lowderd/EmojiPad/README.md

# EmojiPad
ATmega328 Based USB HID Keyboard
