lowderd/EmojiPad/eagleUp/eagleUp_emojipad_v2_board_bottom.png

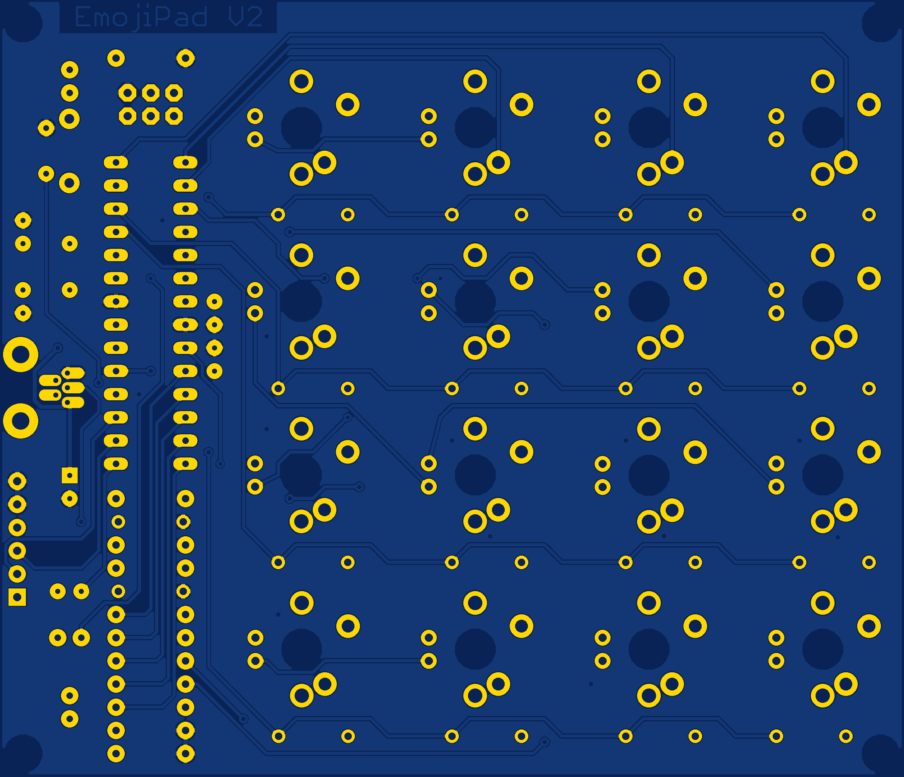
eagleUp/eagleUp_emojipad_v2_board_bottom.png
