lowderd/EmojiPad/eagleUp/eagleUp_emojipad_v2_board_top.png

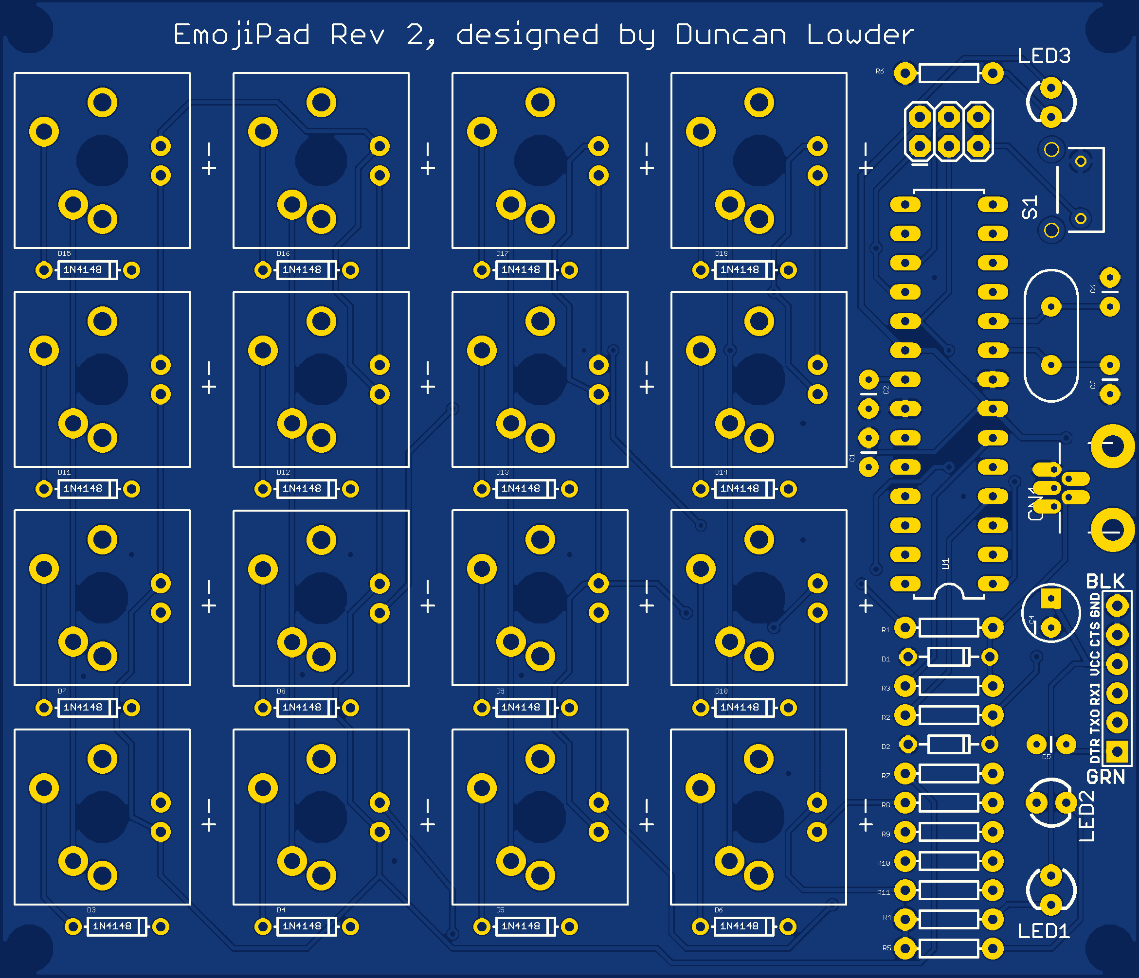
eagleUp/eagleUp_emojipad_v2_board_top.png
