lowderd/EmojiPad/EmojiPad_BOM_V1.xlsx

Sheet: BOM
Bill Of Materials -EmojiPad
Number of Devices: |  | 3
Item # | Designator | Name | Description | Manufacturer | Mfg. Part # | Distributor | Quantity | Price | Total | To Order
1 | U1 |  | IC MCU 8BIT 32KB FLASH 28DIP | Atmel | ATMEGA328-PU | Digikey | 3 | $3.41 | $10.23
2 | Y1 |  | CRYSTAL 16MHZ 20PF THRU | ECS Inc | ECS-160-20-4X | Digikey | 3 | $0.81 | $2.43
3 | C1, C3 |  | CAP CER 0.1UF 50V 20% RADIAL | Kemet | C315C104M5U5TA | Digikey | 6 | $0.30 | $1.80
4 | C2, C5 |  | CAP CER 22PF 200V 10% RADIAL | AVX Corporation | SR152A220KAR | Digikey | 6 | $0.31 | $1.86
5 | C3 |  | CAP ALUM 10UF 50V 20% RADIAL | Panasonic Electronic Components | EEU-FC1H100L | Digikey | 3 | $0.33 | $0.99
6 | R7, R8 |  | RES 68 OHM 1/4W 1% AXIAL | Stackpole Electronics Inc | RNMF14FTC68R0 | Digikey | 6 | $0.14 | $0.84
7 | D1, D2 |  | DIODE ZENER 3.6V 400MW ALF2 | NXP Semiconductors | BZX79-C3V6,133 | Digikey | 6 | $0.14 | $0.84
8 | S1 |  | SWITCH TACTILE SPST-NO 0.05A 24V | TE Connectivity | 1825027-5 | Digikey | 3 | $0.16 | $0.48
9 | R6 |  | RES 1.5K OHM 1/4W 5% CARBON FILM | Stackpole Electronics Inc | CF14JT1K50 | Digikey | 3 | $0.10 | $0.30
10 | CN1 |  | CONN USB RECEPTACLE 5POS RT ANG | Molex Inc | 548190519 | Digikey | 3 | $1.64 | $4.92
11 | D3-D18 |  | DIODE GEN PURP 100V 200MA DO35 | Fairchild Semiconductor | 1N4148TA | Digikey | 48 | $0.06 | $2.78
12 | SW1-SW16 |  | SWITCH PUSH SPST-NO 0.01A 12V | Cherry | MX1A-E1NW | Digikey | 48 | $1.05 | $50.40
13 | LED1-3, SW1-SW16 |  | LED 3MM 468NM BLUE TRANSPARENT | Rohm Semiconductor | SLR343BC7T3F | Digikey | 57 | $0.56 | $31.92
14 | R9, R10, R11 |  | RES 1K OHM 1/4W 5% CARBON FILM | Stackpole Electronics Inc | CF14JT1K00 | Digikey | 9 | $0.10 | $0.90
15 | R1, R2, R3, R4, R5 |  | RES 100 OHM 1/4W 5% CARBON FILM | Stackpole Electronics Inc | CF14JT100R | Digikey | 15 | $0.05 | $0.79
16 | PCB |  | PCB | Seed Studio | PCBA1 | N/A | 3 | $2.20 | $6.60
17 |  |  | 28-PDIP SOCKET | N/A | N/A | N/A | 3 | $0.20 | $0.60
18 |  |  | 0 | 0 | 0 | 0 | 0 | $0.00 | $0.00
Mechanical Parts
19 | TOP | Case Top
20 | BOTTOM | Case Bottom |  |  |  |  |  |  | $0.00
21 | SCREW1-SCREW8 | Screws for PCB and Case | M3 Size, 10 mm Long, 0.5 mm Pitch, Low Profile Socket Head | McMaster-Carr | 90666A105 | McMaster-Carr | 24 | 0.0919 | $2.21
22 | SPACER1-SPACER4 | Spacer for PCB | Aluminum UnThreaded Spacer 4.5 mm OD, 2mm Length | McMaster-Carr | 94669A210 | McMaster-Carr | 12 | 0.35 | $4.20
23 | NUT1-NUT4 | Regular M3 Nut | Zinc Plated, M3x0.5 Thread Size, 5.5mm Wide, 1.8mm High | McMaster-Carr | 90695A033 | McMaster-Carr | 12 | 0.031 | $0.37
24 | NUT5- NUT8 | Acorn Nut | Acorn Nut M3 Size, .5mm Pitch, 5.5mm Width, 6mm Height | McMaster-Carr | 94000A330 | McMaster-Carr | 12 | 0.304 | $3.65
25 | STAND1-STAND5 | Standoffs | Male-Female Hex Threaded Standoff 4.5mm Hex, 16mm Length | McMaster-Carr | 98952A218 | McMaster-Carr | 12 | 1.45 | $17.40
26 |  |  | #REF! | #REF! | #REF! | #REF! |  |  | $0.00
27 |  |  | #REF! | #REF! | #REF! | #REF! |  |  | $0.00
 |  |  |  |  |  |  | Price per Unit |  | $48.84
 |  |  |  |  |  |  | Total |  | $146.51
 |  |  |  |  |  |  | Electrical |  | 118.689
 |  |  |  |  |  |  | Mechanical |  | 27.8256

Sheet: Electrical Component Prices
Electrical Component Prices
 |  |  |  |  |  | Prices
Item # | Description | Manufacturer | Mfg. Part # | Distributor | # Needed | Qty = 1 | Qty = 10 | Qty = 100 | Qty = 500 | Qty = 1000
1 | IC MCU 8BIT 32KB FLASH 28DIP | Atmel | ATMEGA328-PU | Digikey | 1 | 3.41 | 3.045 | 2.497 | 2.02198 | 1.70528
2 | CRYSTAL 16MHZ 20PF THRU | ECS Inc | ECS-160-20-4X | Digikey | 1 | 0.81 | 0.69 | 0.46 | 0.3818 | 0.322
3 | CAP CER 0.1UF 50V 20% RADIAL | Kemet | C315C104M5U5TA | Digikey | 2 | 0.3 | 0.207 | 0.1173 | 0.0828 | 0.07245
4 | CAP CER 22PF 200V 10% RADIAL | AVX Corporation | SR152A220KAR | Digikey | 2 | 0.31 | 0.215 | 0.129 | 0.09676 | 0.0817
5 | CAP ALUM 10UF 50V 20% RADIAL | Panasonic Electronic Components | EEU-FC1H100L | Digikey | 1 | 0.33 | 0.33 | 0.1275 | 0.09 | 0.07875
6 | RES 68 OHM 1/4W 1% AXIAL | Stackpole Electronics Inc | RNMF14FTC68R0 | Digikey | 2 | 0.14 | 0.095 | 0.0394 | 0.0216 | 0.0144
7 | DIODE ZENER 3.6V 400MW ALF2 | NXP Semiconductors | BZX79-C3V6,133 | Digikey | 2 | 0.14 | 0.126 | 0.0825 | 0.04032 | 0.0275
8 | SWITCH TACTILE SPST-NO 0.05A 24V | TE Connectivity | 1825027-5 | Digikey | 1 | 0.16 | 0.156 | 0.1372 | 0.12374 | 0.09415
9 | RES 1.5K OHM 1/4W 5% CARBON FILM | Stackpole Electronics Inc | CF14JT1K50 | Digikey | 1 | 0.1 | 0.053 | 0.0219 | 0.012 | 0.008
10 | CONN USB RECEPTACLE 5POS RT ANG | Molex Inc | 548190519 | Digikey | 1 | 1.64 | 1.485 | 1.2726 | 1.0605 | 0.909
11 | DIODE GEN PURP 100V 200MA DO35 | Fairchild Semiconductor | 1N4148TA | Digikey | 16 | 0.1 | 0.058 | 0.038 | 0.01858 | 0.01267
12 | SWITCH PUSH SPST-NO 0.01A 12V | Cherry | MX1A-E1NW | Digikey | 16 | 1.13 | 1.05 | 0.925 | 0.85 | 0.8
13 | LED 3MM 468NM BLUE TRANSPARENT | Rohm Semiconductor | SLR343BC7T3F | Digikey | 19 | 0.72 | 0.56 | 0.4 | 0.304 | 0.24
14 | RES 1K OHM 1/4W 5% CARBON FILM | Stackpole Electronics Inc | CF14JT1K00 | Digikey | 3 | 0.1 | 0.053 | 0.0219 | 0.012 | 0.008
15 | RES 100 OHM 1/4W 5% CARBON FILM | Stackpole Electronics Inc | CF14JT100R | Digikey | 5 | 0.1 | 0.053 | 0.0219 | 0.012 | 0.008
16 | PCB | Seed Studio | PCBA1 | N/A | 1 | 2.2 | 2.2 | 2.2 | 2.2 | 2.2
17 | 28-PDIP SOCKET | N/A | N/A | N/A | 1 | 0.2 | 0.2 | 0.2 | 0.2 | 0.2
18

Sheet: Mechanical Component Prices
Mechanical Component Prices
 |  |  |  |  |  | Prices
Item # | Description | Manufacturer | Mfg. Part # | Distributor | # Needed | Qty = 1 | Qty = 10 | Qty = 100 | Qty = 500 | Qty = 1000
1 | M3 Size, 10 mm Long, 0.5 mm Pitch, Low Profile Socket Head | McMaster-Carr | 90666A105 | McMaster-Carr | 8 | 0.0919 | 0.0919 | 0.0919 | 0.0919 | 0.0919
2 | Aluminum UnThreaded Spacer 4.5 mm OD, 2mm Length | McMaster-Carr | 94669A210 | McMaster-Carr | 4 | 0.35 | 0.3 | 0.3 | 0.3 | 0.3
3 | Zinc Plated, M3x0.5 Thread Size, 5.5mm Wide, 1.8mm High | McMaster-Carr | 90695A033 | McMaster-Carr | 4 | 0.031 | 0.031 | 0.031 | 0.031 | 0.031
4 | Acorn Nut M3 Size, .5mm Pitch, 5.5mm Width, 6mm Height | McMaster-Carr | 94000A330 | McMaster-Carr | 4 | 0.304 | 0.304 | 0.304 | 0.304 | 0.304
5 | Male-Female Hex Threaded Standoff 4.5mm Hex, 16mm Length | McMaster-Carr | 98952A218 | McMaster-Carr | 4 | 1.45 | 1.23 | 1.23 | 1.23 | 1.23
6 |  |  |  |  |  | 0 | 0 | 0 | 0 | 0
7 |  |  |  |  |  | 0 | 0 | 0 | 0 | 0
8 |  |  |  |  |  | 0 | 0 | 0 | 0 | 0
9 |  |  |  |  |  | 0 | 0 | 0 | 0 | 0
