lowderd/EmojiPad/Key Cap Suppliers.docx

http://keyshop.pimpmykeyboard.com/

http://www.maxkeyboard.com/
