lowderd/EmojiPad/emojipad_v2.brd

## EAGLE design emojipad_v2.brd (2015-04-11)

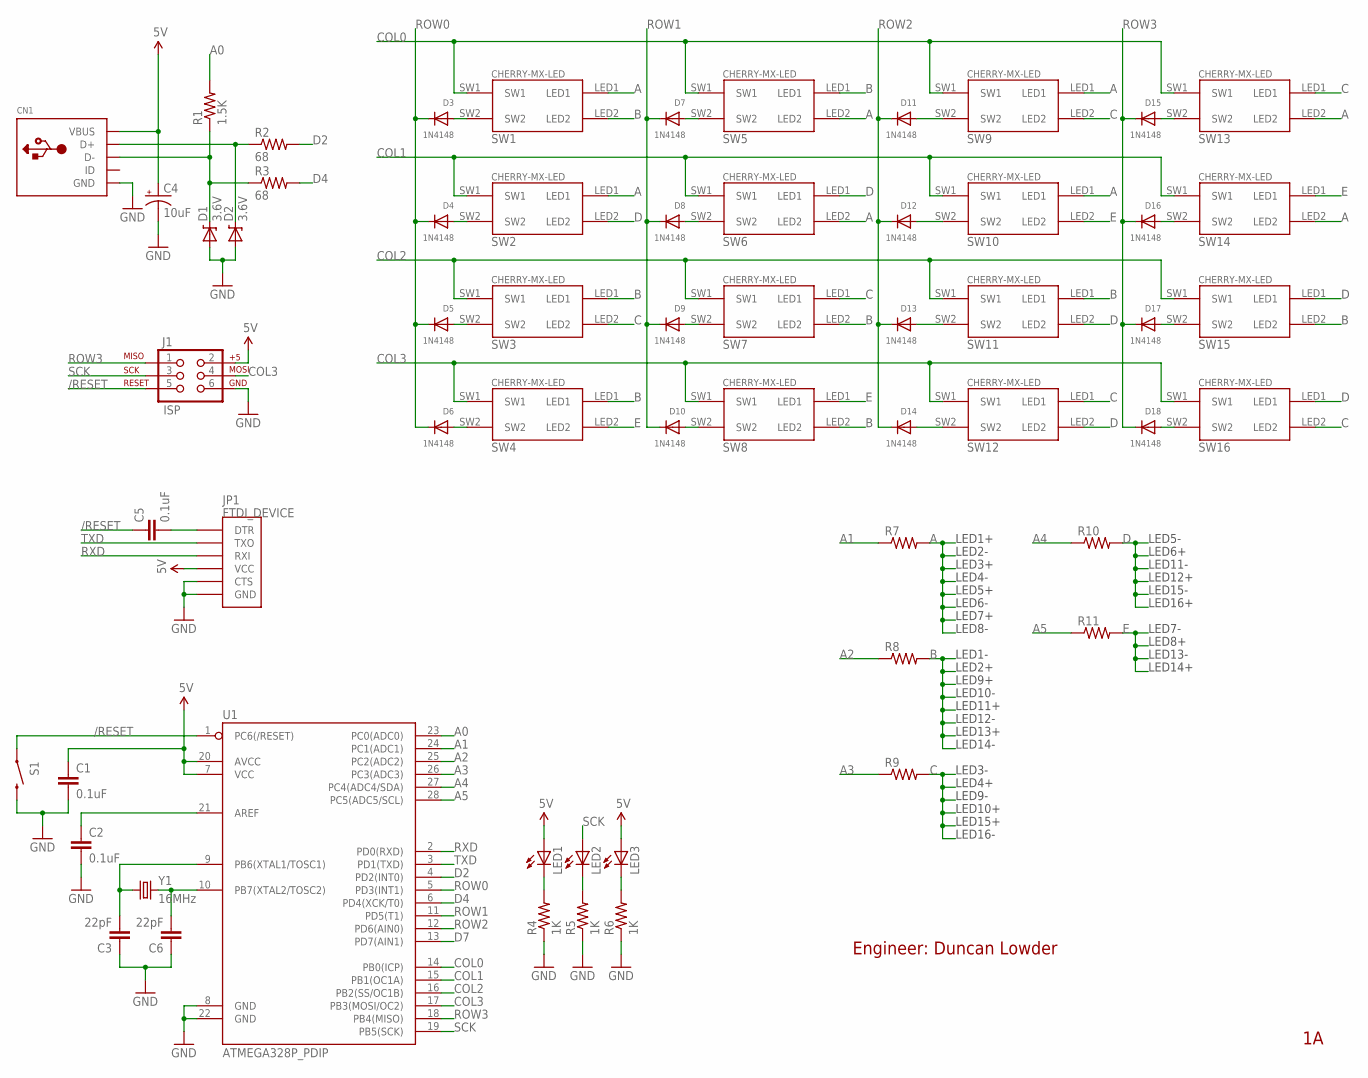
[picture p3: schematic emojipad_v2.sch]

Parts:
C1, C2, C5: 0.1uF; CAP-PTH-SMALL
C3, C6: 22pF; CAP-PTH-SMALL
C4: 10uF; CPOL-RADIAL-10UF-25V
CN1: USBMOLEX; USB-MINIB-THM-MOLEX
D1, D2: 3.6V; DIODE-ZENER
D3, D4, D5, D6, D7, D8, D9, D10, D11, D12, D13, D14, D15, D16, D17, D18: 1N4148; DO-1N4148
J1: ISP; 2X3
JP1: FTDI_DEVICE; FTDI_DEVICE_SIDE
LED1, LED2, LED3: LED3MM
R1: 1.5K; AXIAL-0.3
R2, R3: 68; AXIAL-0.3
R4, R5, R6: 1K; AXIAL-0.3
R7, R8, R9, R10, R11: RESISTORAXIAL-0.3; AXIAL-0.3
S1: SWITCH-MOMENTARY-2SIDE_EZ; TACTILE-PTH-SIDEEZ
SW1, SW2, SW3, SW4, SW5, SW6, SW7, SW8, SW9, SW10, SW11, SW12, SW13, SW14, SW15, SW16: CHERRY-MX-LED
U1: ATMEGA328P_PDIP; DIL28-3
Y1: 16MHz; HC49US

Connections:
5V: C1.1, C4.1 (+), CN1.VBUS, J1.2, JP1.P$4 (VCC), LED1.A, LED3.A, U1.7 (VCC), U1.20 (AVCC)
/RESET: C5.1, J1.5, S1.1, U1.1 (PC6(/RESET))
A: R7.P$2 (2), SW1.LED1, SW2.LED1, SW5.LED2, SW6.LED2, SW9.LED1, SW10.LED1, SW13.LED2, SW14.LED2
A0: R1.P$2 (2), U1.23 (PC0(ADC0))
A1: R7.P$1 (1), U1.24 (PC1(ADC1))
A2: R8.P$1 (1), U1.25 (PC2(ADC2))
A3: R9.P$1 (1), U1.26 (PC3(ADC3))
A4: R10.P$1 (1), U1.27 (PC4(ADC4/SDA))
A5: R11.P$1 (1), U1.28 (PC5(ADC5/SCL))
B: R8.P$2 (2), SW1.LED2, SW3.LED1, SW4.LED1, SW5.LED1, SW7.LED2, SW8.LED2, SW11.LED1, SW15.LED2
C: R9.P$2 (2), SW3.LED2, SW7.LED1, SW9.LED2, SW12.LED1, SW13.LED1, SW16.LED2
COL0: SW1.SW1, SW5.SW1, SW9.SW1, SW13.SW1, U1.14 (PB0(ICP))
COL1: SW2.SW1, SW6.SW1, SW10.SW1, SW14.SW1, U1.15 (PB1(OC1A))
COL2: SW3.SW1, SW7.SW1, SW11.SW1, SW15.SW1, U1.16 (PB2(SS/OC1B))
COL3: J1.4, SW4.SW1, SW8.SW1, SW12.SW1, SW16.SW1, U1.17 (PB3(MOSI/OC2))
D: R10.P$2 (2), SW2.LED2, SW6.LED1, SW11.LED2, SW12.LED2, SW15.LED1, SW16.LED1
D2: R2.P$2 (2), U1.4 (PD2(INT0))
D4: R3.P$2 (2), U1.6 (PD4(XCK/T0))
D7: U1.13 (PD7(AIN1))
D+: CN1.D+, D2.P$1 (C), R2.P$1 (1)
D-: CN1.D-, D1.P$1 (C), R1.P$1 (1), R3.P$1 (1)
E: R11.P$2 (2), SW4.LED2, SW8.LED1, SW10.LED2, SW14.LED1
GND: C1.2, C2.2, C3.1, C4.2 (-), C6.1, CN1.GND, D1.P$2 (A), D2.P$2 (A), J1.6, JP1.P$5 (CTS), JP1.P$6 (GND), R4.P$1 (1), R5.P$1 (1), R6.P$1 (1), S1.2, U1.8 (GND), U1.22 (GND)
unnamed: LED1.K (C), R4.P$2 (2)
unnamed: D3.A, SW1.SW2
unnamed: D4.A, SW2.SW2
unnamed: D5.A, SW3.SW2
unnamed: C2.1, U1.21 (AREF)
unnamed: C6.2, U1.10 (PB7(XTAL2/TOSC2)), Y1.2
unnamed: D6.A, SW4.SW2
unnamed: D7.A, SW5.SW2
unnamed: D8.A, SW6.SW2
unnamed: D9.A, SW7.SW2
unnamed: D10.A, SW8.SW2
unnamed: D11.A, SW9.SW2
unnamed: D12.A, SW10.SW2
unnamed: D13.A, SW11.SW2
unnamed: D14.A, SW12.SW2
unnamed: D15.A, SW13.SW2
unnamed: D16.A, SW14.SW2
unnamed: D17.A, SW15.SW2
unnamed: D18.A, SW16.SW2
unnamed: C3.2, U1.9 (PB6(XTAL1/TOSC1)), Y1.1
unnamed: LED2.K (C), R5.P$2 (2)
unnamed: LED3.K (C), R6.P$2 (2)
unnamed: C5.2, JP1.P$1 (DTR)
ROW0: D3.C, D4.C, D5.C, D6.C, U1.5 (PD3(INT1))
ROW1: D7.C, D8.C, D9.C, D10.C, U1.11 (PD5(T1))
ROW2: D11.C, D12.C, D13.C, D14.C, U1.12 (PD6(AIN0))
ROW3: D15.C, D16.C, D17.C, D18.C, J1.1, U1.18 (PB4(MISO))
RXD: JP1.P$3 (RXI), U1.2 (PD0(RXD))
SCK: J1.3, LED2.A, U1.19 (PB5(SCK))
TXD: JP1.P$2 (TXO), U1.3 (PD1(TXD))

Notes on the sheet:
LED1+
LED2-
LED3+
LED4-
LED5+
LED6-
LED7+
LED8-
LED1-
LED2+
LED9+
LED10-
LED11+
LED12-
LED13+
LED14-
LED3-
LED4+
LED9-
LED10+
LED15+
LED16-
LED5-
LED6+
LED11-
LED12+
LED15-
LED16+
LED7-
LED8+
LED13-
LED14+
Engineer: Duncan Lowder

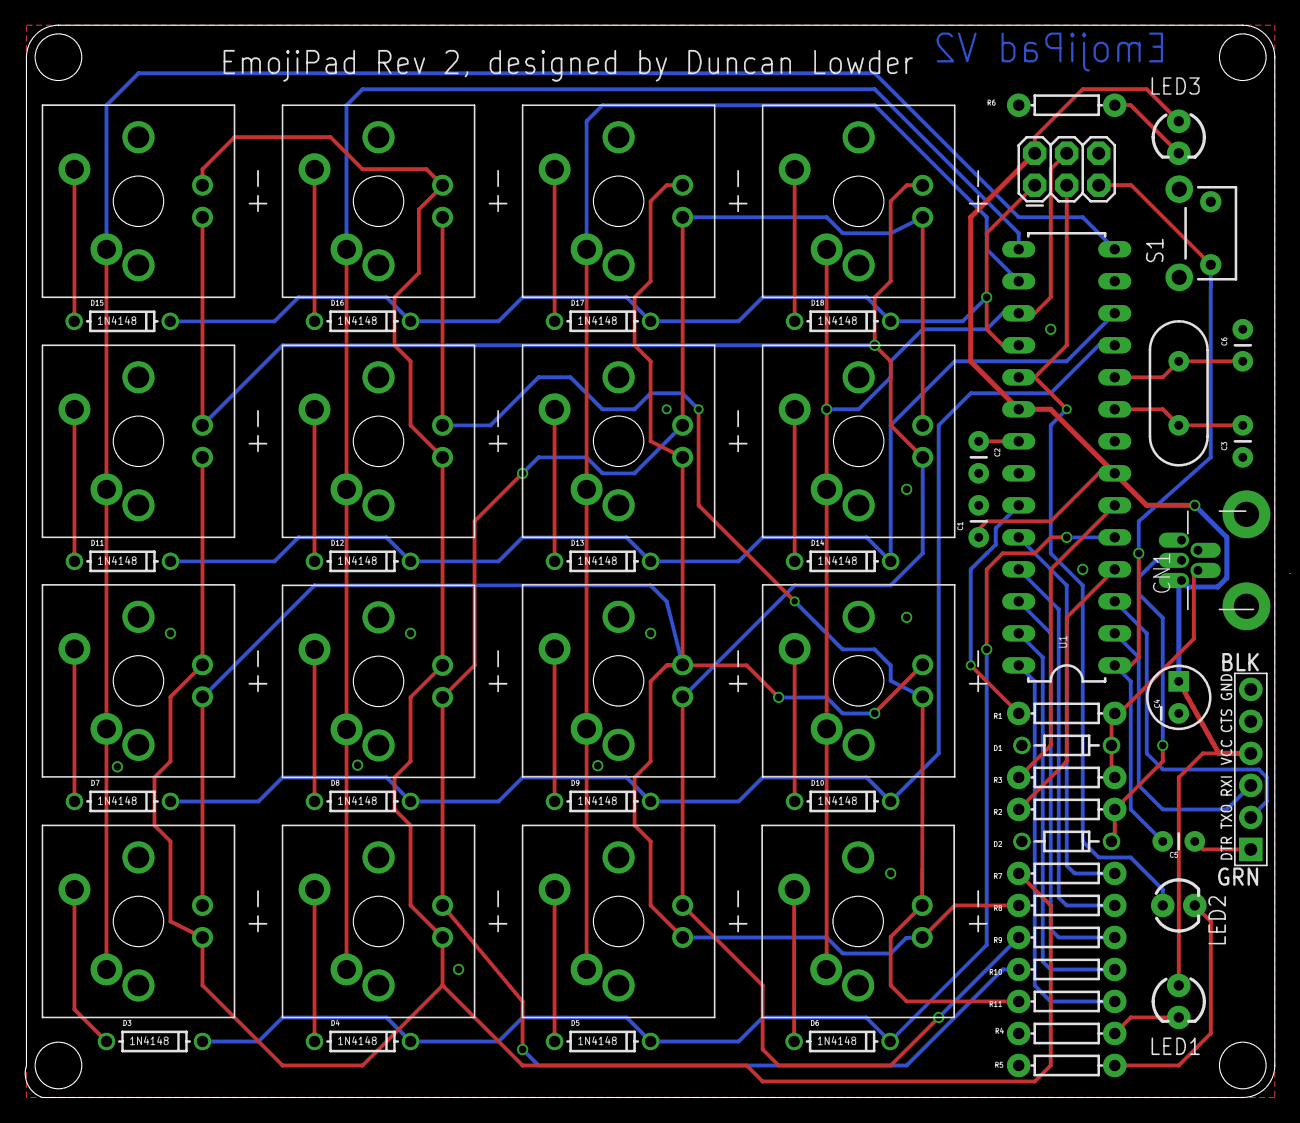
[picture p4: board emojipad_v2.brd from above]

Board: 2 copper layers, 99.2 x 85.1 mm, 60 parts (0 on the bottom side), 52 nets.
