lowderd/EmojiPad/(commit log)

2015-04-09 Initial Commit of EmojiPad Hardware and Firmware Files
    [EmojiPad_BOM_V1.xlsx, emojipad_v1.brd, emojipad_v1.sch, emojipad_v2.brd, emojipad_v2.sch]
2015-04-11 Update to EmojiPad Sketch Files, Modification to V2 of the PCB: Changed pull-up to a GPIO pin, and D- to D12, Initial 3D Model Check In
    [emojipad_v2.brd, emojipad_v2.sch]
2015-04-12 Finished Model of Rev 2 of the PCBA
    [EmojiPad_BOM_V1.xlsx]
2015-04-13 Added EmojiPad Case files, P2 Size for Ponoko Laser Cutting
2015-05-21 Added mapping for new board using membrane keyswitches"
2015-07-15 EmojiPad PCB Rev2 Ready for Order
    [emojipad_v2.sch]
2015-07-15 V2 BOM
    [EmojiPad_BOM_V1.xlsx]
